c0pperdragon/ArduinoGameConsole/doc/hardware.pdf

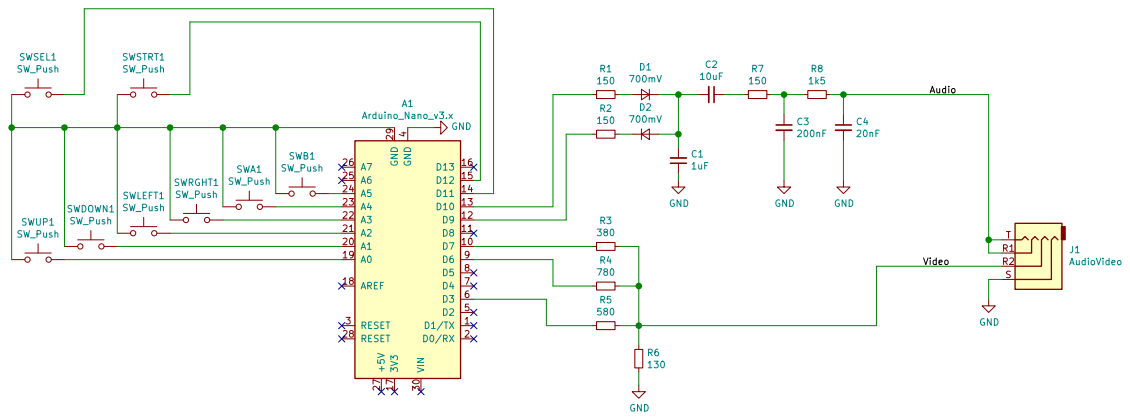
[picture p4: page 1]
