c0pperdragon/ArduinoGameConsole/tetris/artwork_tiles.h

// 0
____,____,
____,____,
____,____,
____,____,
____,____,
____,____,
____,____,
____,____,
#define tB0 1
___X,XXX_,
__Xl,lllX,
_Xl_,l___,
_X__,____,
XO__,____,
XOl_,__l_,
_XOl,llO_,
_XXO,OO__,
#define tC0 2
_XXX,____,
XllX,XX__,
l___,__X_,
_l__,___X,
____,___X,
____,___X,
____,__Xl,
____,__XO,
#define tD0 3
____,____,
____,____,
____,____,
_X__,____,
XlXX,____,
___l,X___,
_l__,_X__,
Ol__,lX__,
#define tO0 4
_XOl,____,
XOOl,____,
XOll,____,
XOl_,____,
XOl_,____,
XOll,____,
XOOl,____,
_XOl,____,
#define tP0 5
____,lOX_,
____,lOOX,
____,llOX,
____,_lOX,
____,_lOX,
____,llOX,
____,lOOX,
____,lOX_,
#define tQ0 6
_XXX,XXX_,
XOOO,OOOX,
OOll,llOO,
lll_,_lll,
____,____,
____,____,
____,____,
____,____,
#define tR0 7
____,____,
____,____,
____,____,
____,____,
____,llll,
____,lOOO,
____,lOXX,
____,lOX_,
#define tB1 8
_XXX,XXOl,
_X_X,Xl__,
Xl_l,____,
Xl__,l___,
XOl_,____,
_XOl,__ll,
__XX,XOOO,
____,_XXX,
#define tC1 9
l___,__XX,
_l__,___X,
____,____,
_l__,____,
llll,l___,
OOXX,Ol_l,
XXX_,_lOO,
XXll,OXXX,
#define tD1 10
XOl_,OXX_,
XOOl,OXX_,
_XXl,XXX_,
__lO,XX__,
llOX,X___,
OOXX,X___,
XXXX,____,
XXX_,____,
#define tE1 11
____,___X,
____,__Xl,
____,XXXX,
___X,_lXX,
__X_,lOOX,
__XX,XXXl,
___X,ll__,
__Xl,__X_,
#define tF1 12
X___,____,
OX__,____,
XXXX,____,
___O,X___,
__ll,OX__,
XOOO,XX__,
_XXX,X___,
_X__,lX__,
#define tG1 13
____,__XX,
____,_X__,
____,_X_l,
____,__XX,
____,__X_,
____,_XX_,
____,_XlO,
____,_XOX,
#define tH1 14
____,____,
X_XX,X___,
XX__,lX__,
___l,XOX_,
__lX,OOX_,
lXX_,XOX_,
X__X,_X__,
___X,lX__,
#define tI1 15
____,____,
___X,XX_X,
__X_,__XX,
_X_X,l___,
_XlO,Xl__,
_XOX,_XX_,
__X_,X__X,
__X_,X___,
#define tJ1 16
XX__,____,
__X_,____,
_lX_,____,
XX__,____,
_X__,____,
_XX_,____,
lOX_,____,
XOX_,____,
#define tK1 17
____,___X,
____,__X_,
____,_XX_,
___X,X_XX,
__X_,___l,
__Xl,____,
_XXX,l___,
_X_l,XXll,
#define tL1 18
X___,____,
_X__,____,
lXXX,____,
XXOl,X___,
OOl_,lX__,
___l,OX__,
_llO,XXX_,
OOXX,lOX_,
#define tM1 19
____,____,
__XX,XX__,
_X__,_lX_,
X___,lOX_,
_X_l,OX__,
Xl__,__X_,
XO__,_lX_,
_X__,lOX_,
#define tO1 20
XXXX,XX__,
XOOO,OOXX,
XOll,lOOO,
XOl_,llll,
XOll,____,
XOOl,____,
_XOl,____,
_XOl,____,
#define tP1 21
__XX,XXXX,
XXOO,OOOX,
OOOl,llOX,
llll,_lOX,
____,llOX,
____,lOOX,
____,lOX_,
____,lOX_,
#define tQ1 22
____,____,
____,____,
____,____,
____,____,
lll_,_lll,
OOll,llOO,
XOOO,OOOX,
_XXX,XXX_,
#define tR1 23
____,____,
____,____,
____,____,
____,____,
llll,____,
OOOl,____,
XXOl,____,
_XOl,____,
#define tA2 24
____,____,
____,____,
____,____,
__XX,X___,
_X_l,OX__,
_XX_,XX__,
_XlO,OX__,
__XX,X___,
#define tB2 25
____,____,
____,____,
___X,X___,
_XX_,_XX_,
X__l,_lX_,
XOl_,l_OX,
XXOl,lOOX,
_X_O,OlOX,
#define tC2 26
XOXX,XXXX,
XXXX,_lOX,
XOl_,_lX_,
Xl__,lOX_,
Xl__,lXX_,
XO_l,OXX_,
XOXO,XXXX,
XXXX,XXXX,
#define tE2 27
__lX,__X_,
__XX,X__l,
_X_l,XXXX,
_XlO,XXXX,
__XX,X__X,
___X,_XX_,
___X,_llX,
____,XXX_,
#define tF2 28
lX_l,Xl__,
l_lX,XX__,
XXXX,_lX_,
XXXX,lOX_,
X__X,XX__,
_XXl,X___,
X_ll,X___,
_XXX,____,
#define tG2 29
____,_XX_,
____,X_lX,
____,X_OX,
____,XlX_,
____,XOXl,
____,_XXX,
____,__X_,
____,___X,
#define tH2 30
__ll,OX__,
lOOO,X___,
XXXX,____,
lXX_,____,
OXX_,____,
X_lX,____,
lOOX,____,
XXX_,____,
#define tI2 31
__X_,___l,
___X,_lOO,
____,XXXX,
____,_XX_,
____,_XXl,
____,X_lX,
____,XlOO,
____,_XXX,
#define tJ2 32
OXX_,____,
X__X,____,
X_lX,____,
lXOX,____,
OXOX,____,
XXX_,____,
OX__,____,
X___,____,
#define tK2 33
__XX,_lXX,
__XX,XXll,
_X_l,X_XX,
_XlX,X___,
__XX,XX_l,
___X,_XXX,
___X,_lOX,
____,XXX_,
#define tL2 34
XXlO,XX__,
OOXX,XX__,
XXlX,_lX_,
_lOX,XOX_,
OOXX,XX__,
XXXl,X___,
X_lO,X___,
_XXX,____,
#define tM2 35
_XlO,OOX_,
__XX,XX__,
___X,____,
___X,X___,
___O,X___,
__X_,X___,
__Xl,X___,
__XO,X___,
#define tN2 36
___X,X___,
__X_,lX__,
__XX,XX__,
__X_,lX__,
__X_,OX__,
__Xl,OXl_,
_lXl,OX__,
__lX,Xl__,
#define tO2 37
_XOl,____,
_XOl,____,
XOOl,____,
XOll,____,
XOl_,llll,
XOll,lOOO,
XOOO,OOXX,
XXXX,XX__,
#define tP2 38
____,lOX_,
____,lOX_,
____,lOOX,
____,llOX,
llll,_lOX,
OOOl,llOX,
XXOO,OOOX,
__XX,XXXX,
#define tQ2 39
____,lOX_,
____,lOXX,
____,lOOO,
____,llll,
____,____,
____,____,
____,____,
____,____,
#define tR2 40
_XOl,____,
XXOl,____,
OOOl,____,
llll,____,
____,____,
____,____,
____,____,
____,____,
#define tA3 41
____,____,
____,__X_,
l__O,____,
__Ol,X___,
___X,__O_,
__O_,_OlX,
_OlX,__X_,
__X_,O___,
#define tB3 42
____,____,
____,____,
__O_,O___,
_Ol_,O_O_,
_O_O,_OlO,
O__O,lO_O,
lO_O,OlOl,
_OO_,Ol_O,
#define tC3 43
____,____,
____,____,
__O_,O___,
_Ol_,O_O_,
_O_O,_OlO,
O__O,lO_O,
lO_O,OlO_,
_OO_,Ol_O,
#define tE3 44
____,___X,
____,__X_,
____,XXXX,
___X,_lXX,
__X_,lOOX,
__XX,XXX_,
___X,ll__,
__Xl,__X_,
#define tF3 45
X___,____,
_X__,____,
XXXX,____,
___O,X___,
__ll,OX__,
XOOO,XX__,
_XXX,X___,
_X__,lX__,
#define tG3 46
____,__XX,
____,_X__,
____,_X_l,
____,__XX,
____,__X_,
____,_X__,
____,_XlO,
____,_XOX,
#define tH3 47
____,____,
X_XX,X___,
XX__,lX__,
___l,XOX_,
__lX,OOX_,
lXX_,XOX_,
X__X,_X__,
___X,lX__,
#define tI3 48
____,____,
___X,XX_X,
__X_,__XX,
_X_X,l___,
_XlO,Xl__,
_XOX,_XX_,
__X_,X__X,
__X_,X___,
#define tJ3 49
XX__,____,
__X_,____,
_lX_,____,
XX__,____,
_X__,____,
_XX_,____,
lOX_,____,
XOX_,____,
#define tK3 50
____,___X,
____,__X_,
____,_XX_,
___X,X_XX,
__X_,___l,
__Xl,____,
_XXX,l___,
_X_l,XXll,
#define tL3 51
X___,____,
_X__,____,
lXXX,____,
XXOl,X___,
OOl_,lX__,
___l,OX__,
_llO,XXX_,
OOXX,lOX_,
#define tM3 52
____,___X,
____,__X_,
____,_XX_,
___X,X_XX,
__X_,___l,
__Xl,____,
_XXX,l___,
_X_l,XXll,
#define tN3 53
X___,____,
_X__,____,
lXXX,____,
XXOl,X___,
OOl_,lX__,
___l,OX__,
_llO,XXX_,
OOXX,lOX_,
#define tO3 54
____,____,
_XX_,____,
XlOX,_X__,
XXX_,XOX_,
____,_XX_,
_XXX,____,
_XOX,____,
__X_,____,
#define tP3 55
____,____,
____,____,
____,____,
____,____,
____,____,
____,___X,
____,__XO,
____,_XOO,
#define tQ3 56
____,____,
____,____,
____,____,
____,____,
____,____,
XXXX,X___,
OOOO,OX__,
__lO,OOX_,
#define tB4 57
____,____,
____,____,
____,____,
____,____,
___O,____,
O__O,l___,
lO_O,O_O_,
_OO_,OlO_,
#define tC4 58
____,____,
____,____,
____,____,
____,____,
___O,____,
O__O,l___,
lO_O,O_O_,
_OO_,OlO_,
#define tE4 59
__lX,__X_,
__XX,X__l,
_X_l,XXXX,
_XlO,X__X,
__XX,_XXl,
___X,_llX,
____,XXX_,
____,____,
#define tF4 60
lX_l,Xl__,
l_lX,XX__,
XXXX,_lX_,
XXXX,lOX_,
X__X,XX__,
_XXl,X___,
X_ll,X___,
_XXX,____,
#define tG4 61
____,_XX_,
____,X__X,
____,X_lX,
____,XlOX,
____,XOXX,
____,_XXX,
____,_XlO,
____,__XX,
#define tH4 62
___l,OX__,
_OOO,X___,
XXXX,____,
_lX_,____,
lOXX,____,
XX_l,X___,
XXlO,X___,
__XX,____,
#define tI4 63
__X_,___l,
___X,_lOO,
____,XXXX,
____,_X_l,
____,XXlO,
___X,_lXX,
___X,lOXX,
____,XX__,
#define tJ4 64
OXX_,____,
X__X,____,
X_lX,____,
X_OX,____,
XXOX,____,
XXX_,____,
lOX_,____,
XX__,____,
#define tK4 65
__XX,_lXX,
__XX,XXll,
_X_l,X_XX,
_XlX,X___,
__XX,XX_l,
___X,_XXX,
___X,_lOX,
____,XXX_,
#define tL4 66
XXlO,XX__,
OOXX,XX__,
XXlX,_lX_,
_lOX,XOX_,
OOXl,XX__,
XXlO,X___,
_XXX,____,
____,____,
#define tM4 67
__XX,_lXX,
__XX,XXll,
_X_l,X_XX,
_XlX,X___,
__XX,XX_l,
___X,lOXX,
____,XXX_,
____,____,
#define tN4 68
XXlO,XX__,
OOXX,XX__,
XXlX,_lX_,
_lOX,XOX_,
OOXX,XX__,
XXXl,X___,
X_lO,X___,
_XXX,____,
#define tP4 69
____,_XO_,
____,_XXX,
____,_X_X,
____,_X__,
____,__X_,
____,___X,
____,__Xl,
____,_XXO,
#define tQ4 70
lOOO,OOX_,
OXXO,OXX_,
X__X,XlX_,
_XX_,llX_,
llll,lX__,
llll,X___,
XXXX,OX__,
llll,OXX_,
#define tF5 71
____,___X,
____,__X_,
____,XXXX,
___X,_lXX,
__X_,lOOX,
__XX,XXX_,
___X,ll__,
__Xl,__X_,
#define tG5 72
X___,____,
_X__,____,
XXXX,____,
___O,X___,
__ll,OX__,
XOOO,XX__,
_XXX,X___,
_X__,lX__,
#define tP5 73
____,X_XO,
____,X_XO,
____,_XXX,
____,_XOl,
____,_XOl,
____,XOOl,
____,XOll,
____,XOl_,
#define tQ5 74
OOOO,OX_X,
l__l,OX_X,
XXXX,XXX_,
l__l,lOX_,
____,lOX_,
____,lOOX,
____,llOX,
____,_lOX,
#define tF6 75
__lX,__X_,
__XX,X__l,
_X_l,XXXX,
_XlO,XXXX,
__XX,X__X,
___X,_XXl,
___X,_llX,
____,XXX_,
#define tG6 76
lX_l,Xl__,
l_lX,XX__,
XXXX,_lX_,
X__X,lOX_,
_XXl,XX__,
X_ll,X___,
_XXX,____,
____,____,
#define tI7 77
____,____,
____,____,
____,____,
____,___X,
____,__Xl,
____,_Xll,
____,Xlll,
___X,lllX,
#define tJ7 78
____,____,
____,____,
____,____,
X___,____,
OX__,____,
OOX_,____,
OOOX,____,
XOOO,X___,
#define tC8 79
____,____,
____,____,
____,____,
____,____,
____,__XX,
____,_X__,
____,Xl__,
___X,_l__,
#define tD8 80
____,____,
____,XXXX,
__XX,llll,
XX__,llll,
ll__,llll,
ll__,llll,
ll__,llll,
ll__,llll,
#define tE8 81
____,____,
XXXX,____,
OOOO,XX__,
OOOO,llXX,
OOOO,llOO,
OOOO,llOO,
OOOO,llOO,
OOOO,llOO,
#define tF8 82
____,____,
____,____,
____,____,
____,____,
XX__,____,
llX_,____,
llOX,____,
llOl,X___,
#define tH8 83
____,____,
____,____,
____,____,
____,____,
____,___X,
____,___X,
____,___X,
____,__Xl,
#define tI8 84
__Xl,llXl,
_Xll,lXl_,
Xlll,Xl__,
Xlll,Xl__,
lllX,l___,
lllX,l___,
lllX,l___,
llXl,____,
#define tJ8 85
lXOO,OX__,
_lXO,OOX_,
__lX,OOOX,
__lX,OOOX,
___l,XOOO,
___l,XOOO,
___l,XOOO,
____,lXOO,
#define tK8 86
____,____,
____,____,
____,____,
____,____,
X___,____,
X___,____,
X___,____,
OX__,____,
#define tC9 87
__Xl,_l__,
__Xl,_l__,
_X_l,_l__,
_X_l,_l_X,
Xl_l,_lXO,
Xl_l,_XOO,
Xl_l,XOOl,
Xl_l,XOll,
#define tD9 88
ll__,XXXX,
llXX,OOOO,
XXOO,OOOl,
OOOO,llll,
OOll,l___,
lll_,____,
l___,____,
____,____,
#define tE9 89
XXXX,llOO,
OOOO,XXOO,
llll,llXX,
l___,_lll,
____,____,
____,____,
____,____,
____,____,
#define tF9 90
llOl,OX__,
llOl,OX__,
llOl,OlX_,
XlOl,OlX_,
lXOl,OlOX,
__Xl,OlOX,
___X,OlOX,
___X,OlOX,
#define tH9 91
____,__Xl,
____,__Xl,
____,__Xl,
____,_Xll,
____,_Xll,
____,_Xll,
____,Xlll,
____,Xlll,
#define tI9 92
llXl,____,
llXl,____,
llXl,____,
lXl_,____,
lXl_,____,
lXl_,____,
XOl_,____,
XOll,____,
#define tJ9 93
____,lXOO,
____,lXOO,
____,lXOO,
____,_lXO,
____,_lXO,
____,_lXO,
____,_lOX,
____,llOX,
#define tK9 94
OX__,____,
OX__,____,
OX__,____,
OOX_,____,
OOX_,____,
OOX_,____,
OOOX,____,
OOOX,____,
#define tCa 95
Xl_X,Oll_,
Xl_X,ll__,
XlXl,l___,
XlXl,____,
XXll,____,
XXl_,____,
XXl_,____,
XOll,____,
#define tFa 96
____,XlOX,
____,XlOX,
____,_XOX,
____,_XOX,
____,_lXX,
____,_lXX,
____,_lXX,
____,llOX,
#define tHa 97
___X,llll,
___X,lllX,
__Xl,lllX,
__Xl,llXO,
_Xll,llXO,
_Xll,lXOO,
Xlll,lXOO,
Xlll,XOOO,
#define tIa 98
XOOl,____,
OOOl,l___,
OOOO,ll__,
OOOO,Olll,
OOOO,OOll,
OOOO,OOOO,
OXXX,XXXX,
X___,____,
#define tJa 99
____,lOOX,
___l,lOOO,
__ll,OOOO,
lllO,OOOO,
llOO,OOOO,
OOOO,OOOO,
XXXX,XXXO,
llll,lllX,
#define tKa 100
OOOO,X___,
XOOO,X___,
XOOO,OX__,
OXOO,OX__,
OXOO,OOX_,
OOXO,OOX_,
OOXO,OOOX,
OOOX,OOOX,
#define tCb 101
XOll,____,
XOOl,ll__,
XOOO,Olll,
XOOO,OOOO,
_XXX,XXXX,
_XOO,OOOO,
_Xll,llll,
_X__,___l,
#define tDb 102
____,XXXX,
___X,OOOl,
llXO,Oll_,
OOXO,lXXX,
XXOO,X___,
OXOl,X___,
OXOl,X__l,
lXOl,X_l_,
#define tEb 103
XXXX,____,
ll__,X___,
____,_Xll,
XXX_,_XOO,
_l_X,_OXX,
l_OX,_OXO,
_OlX,lOX_,
OlXX,lOX_,
#define tFb 104
____,llOX,
__ll,lOOX,
lllO,OOOX,
OOOO,OOOX,
XXXX,XXX_,
OOOO,OOX_,
llll,lOX_,
___l,lOX_,
#define tHb 105
XlXX,OOOX,
XXOO,OOOX,
_XOO,OOOX,
__XX,XOOX,
__X_,_XXX,
__X_,___X,
__X_,___X,
__X_,__lX,
#define tIb 106
__lO,lOlO,
_OlO,lXlO,
_OlO,lXlO,
_OlX,lXOO,
_OlX,lXOX,
_XlX,lXXX,
_XlX,OXXX,
_XlX,OXXX,
#define tJb 107
lOlO,lOll,
lOlO,lXlO,
lXlO,lXlO,
lXlX,lXlO,
lXOX,lXlX,
lXOX,OXlX,
lXXX,OXOX,
OXXX,XXOX,
#define tKb 108
XOOO,XXOX,
XOOO,OOXX,
XOOO,OOX_,
XOOX,XX__,
XXX_,lX__,
X___,lX__,
X___,lX__,
X__l,lX__,
#define tCc 109
_X__,____,
_X__,____,
_X__,____,
_X__,____,
_X__,____,
_X__,____,
_X__,____,
_X__,____,
#define tDc 110
lXOl,Xl_O,
lXOl,_XXX,
lXOl,___O,
_XOl,___O,
_XOl,___O,
_XOl,__lO,
_XOl,__lO,
_XXX,XXXX,
#define tEc 111
lXOX,lOX_,
XXXl,lOX_,
lll_,lOX_,
l__l,OOX_,
l__l,OOX_,
l__l,OOX_,
l_lO,OOX_,
XXXX,XXX_,
#define tFc 112
____,lOX_,
____,lOX_,
____,lOX_,
____,OOX_,
____,OOX_,
___l,OOX_,
___l,OOX_,
___l,OOX_,
#define tHc 113
__X_,__lX,
__X_,__lX,
__X_,__lX,
__X_,_llX,
__X_,_llX,
__X_,lllX,
___X,XXlX,
____,__XX,
#define tIc 114
_XOX,XXXX,
_XOX,XXXX,
lXXX,XXXX,
lXXX,XXXX,
lXXX,XXXX,
lXXX,XXXX,
lXXX,XXXX,
XXXX,XXXX,
#define tJc 115
OXXX,XXXX,
XXXX,XXXX,
XXXX,XXXX,
XXXX,XXXX,
XXXX,XXXX,
XXXX,XXXX,
XXXX,XXXX,
XXXX,XXXX,
#define tKc 116
X__l,lX__,
X__l,OX__,
X__l,OX__,
X_ll,OX__,
X_ll,OX__,
XllO,OX__,
XlXX,X___,
XX__,____,
#define tCd 117
_X__,____,
_X__,___X,
_X__,___X,
_XXX,__X_,
____,XXll,
____,_XXX,
____,____,
____,____,
#define tDd 118
XXXX,XXXX,
____,_lll,
XXXX,XXXX,
____,____,
llll,llOO,
XXXX,XXXX,
____,____,
____,____,
#define tEd 119
XXXX,XXXX,
llll,llll,
XXXX,XXXX,
_lll,llll,
OOOO,OOOO,
XXXX,XXXX,
____,____,
____,____,
#define tFd 120
___O,OOX_,
X_lO,OOX_,
XllO,OOX_,
lXOO,XXX_,
OOXX,____,
XXX_,____,
____,____,
____,____,
#define tBe 121
____,___X,
____,__X_,
____,_Xl_,
____,X_l_,
___X,l_l_,
__X_,l_l_,
_Xl_,l_l_,
X_l_,l_l_,
#define tCe 122
XXXX,XXXX,
llll,llll,
llll,llll,
llll,llll,
llll,llll,
llll,llll,
llll,llll,
llll,llll,
#define tDe 123
XXXX,XXXX,
llll,llll,
llll,llll,
llll,llll,
llll,llll,
llll,llll,
llll,llll,
llll,llll,
#define tEe 124
XXXX,XXXX,
llll,llll,
llll,llll,
llll,llll,
llll,llll,
llll,llll,
llll,llll,
llll,llll,
#define tFe 125
XXXX,XXXX,
llll,llll,
llll,llll,
llll,llll,
llll,llll,
llll,llll,
llll,llll,
llll,llll,
#define tGe 126
XXXX,XXXX,
llll,lllO,
llll,lllO,
llll,llOO,
llll,lOlO,
llll,OlOO,
llll,lOlO,
llll,OlOO,
#define tHe 127
X___,____,
_X__,____,
_OX_,____,
_O_X,____,
_O_O,X___,
_O_O,_X__,
_O_O,_OX_,
_O_O,_O_X,
#define tJe 128
____,____,
____,____,
____,____,
____,___X,
____,XXXl,
__XX,llll,
_Xll,llll,
Xlll,llll,
#define tKe 129
____,____,
____,___X,
___X,XXXl,
XXXl,llll,
llll,llll,
llll,llll,
llll,llll,
llll,llll,
#define tLe 130
____,XXXX,
XXXX,llll,
llll,XXXX,
lllX,lXXX,
llXl,XOOO,
lXlX,O_ll,
lXXO,_lOO,
XlXO,lOOX,
#define tMe 131
XXXX,____,
llll,XXXX,
XXXX,lOlO,
XXXO,XlOl,
OOOX,OXlO,
OOOO,XOXO,
OOOO,OXXl,
XOOO,OXOX,
#define tNe 132
____,____,
X___,____,
lXXX,X___,
OlOl,OXXX,
lOOO,OOOO,
OOOO,OOOO,
OOOO,OOOO,
OOOO,OOOO,
#define tOe 133
____,____,
____,____,
____,____,
X___,____,
OXXX,____,
OOOO,XX__,
OOOO,OOX_,
OOOO,OOOX,
#define tBf 134
X_l_,l_l_,
X_l_,l_l_,
X_l_,l_l_,
X_l_,l_l_,
X_l_,l_lX,
X_l_,l_Xl,
X_l_,lXlX,
X_l_,XlX_,
#define tCf 135
llll,llll,
llll,llll,
llll,llll,
llll,llll,
XXXX,XXXX,
llll,llll,
XXXX,XXXX,
____,____,
#define tDf 136
llll,llll,
llll,llll,
llll,llll,
llll,llll,
XXXX,XXXX,
llll,llll,
XXXX,XXXX,
____,____,
#define tEf 137
llll,llll,
llll,llll,
llll,llll,
llll,llll,
XXXX,XXXX,
llll,OOOO,
XXXX,XXXX,
____,____,
#define tFf 138
llll,llll,
llll,llll,
llll,llll,
llll,llll,
XXXX,XXXX,
OOOO,OOOO,
XXXX,XXXX,
____,____,
#define tGf 139
lllO,lOlO,
llOl,OOOO,
lOlO,lOOO,
OlOO,OOOO,
XXXX,XXXX,
OOOO,OOOO,
XXXX,XXXX,
____,____,
#define tHf 140
_O_O,_O_X,
_O_O,_O_X,
_O_O,_O_X,
_O_O,_O_X,
XO_O,_O_X,
OX_O,_O_X,
XOXO,_O_X,
_XOX,_O_X,
#define tJf 141
Xlll,llll,
Xlll,llll,
_Xll,llll,
_XXX,XXXX,
_X__,____,
_X__,____,
_X_X,XXXX,
_X_X,XOOO,
#define tKf 142
llll,llll,
llll,lllX,
llll,lllX,
XXXl,llXl,
___X,XXll,
____,__XX,
XXX_,____,
OllX,XX__,
#define tLf 143
XlXX,XOX_,
llX_,_XX_,
llX_,___X,
lOX_,____,
llOX,____,
XOlO,Xlll,
_XXO,OXXX,
___X,XXXX,
#define tMf 144
_XOX,XXOX,
_XX_,lXOX,
X___,lXOO,
___l,lXOO,
__ll,XOOO,
lllX,OOOX,
XXXO,OXX_,
XXXX,X___,
#define tNf 145
OOOO,OOOO,
XOOO,OOOO,
XOOO,OOOO,
OXOO,OXXX,
OXXX,X___,
XX__,____,
____,_XXX,
__XX,XOOl,
#define tOf 146
OOOO,OOOX,
OOOO,OOOX,
OOOO,OOX_,
XXXX,XXX_,
____,__X_,
____,__X_,
XXXX,X_X_,
llll,X_X_,
#define tBg 147
X_lX,lX__,
X_Xl,X___,
XXlX,____,
XlX_,____,
XX__,____,
XX__,____,
_X__,____,
_X__,____,
#define tCg 148
_XXX,XXX_,
X___,_l_X,
X___,l_OX,
X__l,_O_X,
X_l_,O_XX,
Xl_O,_X_X,
X_O_,X_XX,
_XXX,XXX_,
#define tDg 149
_XXX,XXXX,
_Xll,llll,
_Xl_,___l,
_Xl_,___l,
_Xl_,___l,
_Xl_,___l,
_Xl_,___l,
_Xll,llll,
#define tEg 150
XXXX,XXX_,
Olll,llX_,
Ol__,_lX_,
Ol__,_lX_,
Ol__,_lX_,
Ol__,_lX_,
Ol__,_lX_,
Olll,llX_,
#define tFg 151
_XXX,XXX_,
X___,_l_X,
X___,l_OX,
X__l,_O_X,
X_l_,O_XX,
Xl_O,_X_X,
X_O_,X_XX,
_XXX,XXX_,
#define tGg 152
_XXX,XXX_,
X___,_l_X,
X___,l_OX,
X__l,_O_X,
X_l_,O_XX,
Xl_O,_X_X,
X_O_,X_XX,
_XXX,XXX_,
#define tHg 153
__XO,XO_X,
___X,OX_X,
____,XOXX,
____,_XOX,
____,__XX,
____,__XX,
____,__X_,
____,__X_,
#define tJg 154
_X_X,XOOO,
_X_X,XOOO,
_X_X,XOOO,
_X_X,XOOO,
_X_X,XOOO,
_X_X,XOOO,
_X_X,XOOO,
_X_X,XXXX,
#define tKg 155
Olll,l_XX,
Olll,l__X,
Olll,l__X,
Olll,l__X,
Olll,l__X,
Olll,l__X,
Olll,l__X,
XXXl,l__X,
#define tLg 156
__XX,XXXX,
_XXX,XOXO,
_XXX,OXOX,
_XXO,XOXO,
_XXX,OXOO,
_XXO,XOOO,
_XOX,OOOO,
_XXO,OOOO,
#define tMg 157
OXOX,OX__,
XOXO,OOX_,
OOOO,OOX_,
OOOO,OOX_,
OOOO,OOX_,
OOOO,OOX_,
OOOO,OOX_,
OOOO,OOX_,
#define tNg 158
XXXO,OOOl,
XXXO,OOOl,
XXXO,OOOl,
XXXO,OOOl,
XXXO,OOOl,
XXXO,OOOl,
XXXO,OOOl,
XXXO,OXXX,
#define tOg 159
llll,X_X_,
llll,X_X_,
llll,X_X_,
llll,X_X_,
llll,X_X_,
llll,X_X_,
llll,X_X_,
XXXX,X_X_,
#define tBh 160
_X__,____,
_Xll,llll,
_X__,____,
_Xll,llll,
_Xll,llll,
_Xll,llll,
_Xll,llll,
_Xll,llll,
#define tCh 161
____,____,
llll,llll,
____,____,
llll,llll,
llll,llll,
llll,llll,
llll,llll,
llll,llll,
#define tDh 162
_XOO,OOOO,
lXll,llll,
_Xl_,___l,
lXl_,___l,
lXl_,___l,
lXl_,___l,
lXl_,___l,
lXll,llll,
#define tEh 163
OOOO,OOX_,
Olll,llXl,
Ol__,_lX_,
Ol__,_lXl,
Ol__,_lXl,
Ol__,_lXl,
Ol__,_lXl,
Olll,llXl,
#define tFh 164
____,____,
llll,llll,
____,____,
llll,llll,
llll,llll,
llll,llll,
llll,llll,
llll,llll,
#define tGh 165
____,____,
llll,llll,
____,____,
llll,llll,
llll,llll,
llll,llll,
llll,llll,
llll,llll,
#define tHh 166
____,__X_,
llll,llX_,
____,__X_,
llll,llX_,
llll,llX_,
llll,llX_,
llll,llX_,
llll,llX_,
#define tJh 167
_X__,____,
_X__,____,
__XX,XXXX,
____,____,
____,____,
____,____,
____,____,
____,____,
#define tKh 168
___X,XX_X,
____,__XX,
XXX_,____,
___X,XX__,
____,__XX,
____,____,
____,____,
____,____,
#define tLh 169
_XOX,OOOO,
_XXO,OOOO,
_XOO,OOOO,
_XOO,OOOO,
XXXX,XXXX,
____,____,
____,____,
____,____,
#define tMh 170
OOOO,OOX_,
OOOO,OOX_,
OOOO,OOX_,
OOOO,OOX_,
XXXX,XXXX,
____,____,
____,____,
____,____,
#define tNh 171
XXXX,X___,
XX__,____,
____,_XXX,
__XX,X___,
XX__,____,
____,____,
____,____,
____,____,
#define tOh 172
____,__X_,
____,__X_,
XXXX,XX__,
____,____,
____,____,
____,____,
____,____,
____,____,
