c0pperdragon/ArduinoGameConsole/tetris/tetris_tiles.h

#define TILE_WHITE 0
    ____,____,
    ____,____,
    ____,____,
    ____,____,
    ____,____,
    ____,____,
    ____,____,
    ____,____,
#define TILE_BLACK 1
    XXXX,XXXX,
    XXXX,XXXX,
    XXXX,XXXX,
    XXXX,XXXX,
    XXXX,XXXX,
    XXXX,XXXX,
    XXXX,XXXX,
    XXXX,XXXX,
#define TILE_WALL 2
    OOOX,OOOX,
    lX_l,lX_l,
    lXll,lXll,
    lXll,lXll,
    OXOO,OXOO,
    _llX,_llX,
    lllX,lllX,
    lllX,lllX,
#define TILE_BOX_LT 3
    XXXX,XXXX,
    XXXX,XXXX,
    XXXX,XXXX,
    XXXX,XXXX,
    XXXX,XXXX,
    XXXX,XX__,
    XXXX,X__O,
    XXXX,X_OO,
#define TILE_BOX_T 4
    XXXX,XXXX,
    XXXX,XXXX,
    XXXX,XXXX,
    XXXX,XXXX,
    XXXX,XXXX,
    ____,____,
    OOOO,OOOO,
    ____,____,
#define TILE_BOX_RT 5
    XXXX,XXXX,
    XXXX,XXXX,
    XXXX,XXXX,
    XXXX,XXXX,
    XXXX,XXXX,
    __XX,XXXX,
    O__X,XXXX,
    OO_X,XXXX,
#define TILE_BOX_L 6
    XXXX,X_O_,
    XXXX,X_O_,
    XXXX,X_O_,
    XXXX,X_O_,
    XXXX,X_O_,
    XXXX,X_O_,
    XXXX,X_O_,
    XXXX,X_O_,
#define TILE_BOX_R 7
   _O_X,XXXX,
   _O_X,XXXX,
   _O_X,XXXX,
   _O_X,XXXX,
   _O_X,XXXX,
   _O_X,XXXX,
   _O_X,XXXX,
   _O_X,XXXX,
#define TILE_BOX_LB 8
    XXXX,X_OO,
    XXXX,X__O,
    XXXX,XX__,
    XXXX,XXXX,
    XXXX,XXXX,
    XXXX,XXXX,
    XXXX,XXXX,
    XXXX,XXXX,
#define TILE_BOX_B 9
    ____,____,
    OOOO,OOOO,
    ____,____,
    XXXX,XXXX,
    XXXX,XXXX,
    XXXX,XXXX,
    XXXX,XXXX,
    XXXX,XXXX,
#define TILE_BOX_RB 10
    OO_X,XXXX,
    O__X,XXXX,
    __XX,XXXX,
    XXXX,XXXX,
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
___X,X___,
// 125
____,____,
_XXX,XXX_,
_XXX,X___,
_XXX,XX__,
_XX_,XXX_,
_XX_,_XX_,
____,_XX_,
____,____,
// 126
____,X___,
___X,X___,
__XX,X___,
_XXX,X___,
__XX,X___,
___X,X___,
____,X___,
____,____,
// 127
___X,____,
___X,X___,
___X,XX__,
___X,XXX_,
___X,XX__,
___X,X___,
___X,____,
____,____,
