c0pperdragon/ArduinoGameConsole/(commit log)

2020-01-12 Small working demo for music and partial video signal
    [hardware.kicad_pcb, hardware.sch]
2020-02-26 More doc
    [hardware.kicad_pcb, hardware.sch]
